patrickhener/dARts/docs/Hardware.rst

Hardware
========

Nachfolgend wird die Hardware aufgeführt, die zum Bau des Automaten notewendig ist.

Gekauft habe ich
----------------

Die nachfolgenden Teile sind eine Empfehlung und entsprechen den Teilen, die ich gekauft habe:

* Ardunio Mega 2560 (China Nachbau): |Arduino|
* Raspberry PI 3B+: |Pi|
* Knopf: |Knopf|
* Piezo Sensoren: |Piezo|
* Ultraschall Sensor: |US|
* Löwen Komplett Set inklusive Matrix: |LKS|
* Schloss: |Schloss|

Sonstiges hatte ich noch
------------------------

Was man sonst noch so braucht, habe ich noch rumliegen gehabt:

* Lötkolben
* Litze
* Prototyping Steckplatinen
* Lochraster Lötplatinen
* Widerstandsset
* Schrumpfschlauch
* Jumper Kabel
* LED Band 12V

.. |Arduino| raw:: html

    <a href="https://www.amazon.de/gp/product/B071D4KP6B/ref=ppx_yo_dt_b_search_asin_title?ie=UTF8&psc=1" target="_blank">Amazon</a>

.. |Pi| raw:: html

    <a href="https://www.amazon.de/Raspberry-1373331-Pi-Modell-Mainboard/dp/B07BDR5PDW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" target="_blank">Amazon</a>

.. |Knopf| raw:: html

    <a href="https://www.amazon.de/gp/product/B071VYM413/ref=ppx_yo_dt_b_asin_title_o02_s00?ie=UTF8&psc=1" target="_blank">Amazon</a>

.. |Piezo| raw:: html

    <a href="https://www.amazon.de/gp/product/B07KT4HC4G/ref=ppx_yo_dt_b_asin_title_o03_s00?ie=UTF8&psc=1" target="_blank">Amazon</a>

.. |US| raw:: html

    <a href="https://www.amazon.de/gp/product/B00LSJWRXU/ref=ppx_yo_dt_b_asin_title_o03_s00?ie=UTF8&psc=1" target="_blank">Amazon</a>

.. |LKS| raw:: html

    <a href="https://dartdoktor.de/lowen-darts/178--loewen-dart-komplett-set-nr3-matrix.html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" target="_blank">DartDoktor.de</a>

.. |Schloss| raw:: html

    <a href="https://dartdoktor.de/schloss/311-schloss-target-dart-tuer.html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" target="_blank">DartDoktor.de</a>
