patrickhener/dARts/docs/Holz.rst

Einkaufsliste Holz mit Vermaßung
================================

Ich habe einen Bauplan entworfen, der sich stark an |Video| orientiert. Die nachfolgenden Maße an Holz haben für mich gut funktioniert:

MDF
---

* Segmentbrett: 480mm x 520mm x 12mm

Sperrholz/Multiplex
-------------------

* Matrixbrett: 520mm x 520mm x 18mm
* Türe: 600mm x 750mm x 12mm
* Rückwand: 600mm x 750mm x 12mm
* 3x Stirnbretter: 750mm x 200mm x 12mm
* Boden: 750mm x 200mm x 12mm

.. |Video| raw:: html

    <a href="https://www.youtube.com/watch?v=mV_-dOnWDoY">Strappis Youtube Video</a>
