patrickhener/dARts/docs/index.rst

.. dARts documentation master file, created by
   sphinx-quickstart on Tue Jun 18 13:06:39 2019.
   You can adapt this file completely to your liking, but it should at least
   contain the root `toctree` directive.

Willkommen bei dARts!
=====================

Dies ist die Doku für das Projekt dARts. Eine Arduino und Raspberry Pi gesteuerte elektronische Dartscheibe in Automatenqualität.
Gestützt vom Scoreboard System |Dart-O-Mat 3000|

.. |Dart-O-Mat 3000| raw:: html

  <a href="https://github.com/patrickhener/dart-o-mat-3000/" target="_blank">Dart-O-Mat 3000</a>

.. toctree::
   :maxdepth: 1

   Motivation.rst
   Hardware.rst
   Holz.rst
   Kosten.rst
   Pinbelegung.rst
   Bauanleitung.rst
   Arduino.rst
   Python.rst
   System.rst
