patrickhener/dARts/docs/Kosten.rst

Hochrechnung aller Kosten
=========================

* Arduino: 16,00 €
* Header Platine: 17,50 €
* Raspberry Pi: 32,00 €
* SD Karte: 7,00 €
* Knopf: 8,00 €
* Piezos: 10,00 €
* Ultraschall Sensor: 4,00 €
* Löwen Komplett Set inklusive Matrix: 190,00 €
* Schloss: 10,00 €
* MDF: 2,50 €
* Sperrholz/Multiplex: 45,00 €
* Farbe: 9,00 €
* Walzen: 4,50 €
* Klebezahlen: 20,00 €

Nicht berücksichtigt wurden
---------------------------

* LED Band: 15,50 € (|LED|)
* Netzteil (Kombination aus Steckernetzteil und Adapter): 20,00 € (|Netzteil1| und |Netzteil2|)
* Kleinteile, wie zum Beispiel Litze, Widerstände, Schrumpfschlauch, ...: 25,00 €

.. |LED| raw:: html

  <a href="https://www.led-konzept.de/LED-Streifen-12V-weiss-24W-pro-5m-neutralweiss-200cm-ohne-Anschluesse" target="_blank">led-konzept.de</a>

.. |Netzteil1| raw:: html

  <a href="https://www.amazon.de/Goobay-Spannung-Adapterkabel-4-polig-3-polig/dp/B003KR3UMK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" target="_blank">Amazon</a>

.. |Netzteil2| raw:: html

  <a href="https://www.amazon.de/NAVILOCK-Netzteil-ext-240V-4-Pin/dp/B002V9S46K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" target="_blank">Amazon</a>

Summe
-----

Die Summe beläuft sich demnach auf: 436,00 €
