patrickhener/dARts/docs/Pinbelegung.rst

.. _Pinbelegung:
.. Tabelle generiert mit http://www.tablesgenerator.com/text_tables#

Pinbelegung
===========

+----------------------------+----------+-------------+
| Komponente                 | PIN      | PIN Arduino |
+----------------------------+----------+-------------+
| Push Button                | LED +    | 3           |
+                            +----------+-------------+
|                            | LED -    | GND         |
+                            +----------+-------------+
|                            | Signal + | 2           |
+                            +----------+-------------+
|                            | Signal - | GND         |
+----------------------------+----------+-------------+
| Ultraschall                | VCC      | 5V          |
+ Sensor                     +----------+-------------+
|                            | TRIG     | 9           |
+                            +----------+-------------+
|                            | ECHO     | 8           |
+                            +----------+-------------+
|                            | GND      | GND         |
+----------------------------+----------+-------------+
| Piezo1                     | S        | A0          |
+                            +----------+-------------+
|                            | \-       | GND         |
+----------------------------+----------+-------------+
| Piezo2                     | S        | A1          |
+                            +----------+-------------+
|                            | \-       | GND         |
+----------------------------+----------+-------------+
| Matrix Stecker             | 1        | 22          |
+                            +----------+-------------+
|                            | 2        | 24          |
+                            +----------+-------------+
|                            | 3        | 26          |
+                            +----------+-------------+
|                            | 4        | 28          |
+                            +----------+-------------+
|                            | 5        | 30          |
+                            +----------+-------------+
|                            | 6        | 32          |
+                            +----------+-------------+
|                            | 7        | 34          |
+                            +----------+-------------+
|                            | 8        | 36          |
+                            +----------+-------------+
|                            | 9        | 38          |
+                            +----------+-------------+
|                            | 10       | 40          |
+                            +----------+-------------+
|                            | 11       | 42          |
+                            +----------+-------------+
|                            | 12       | 44          |
+                            +----------+-------------+
|                            | 13       | 46          |
+                            +----------+-------------+
|                            | 14       | 48          |
+                            +----------+-------------+
|                            | 15       | 50          |
+                            +----------+-------------+
|                            | 16       | 52          |
+                            +----------+-------------+
|                            | 17       | 53          |
+                            +----------+-------------+
|                            | 18       | 51          |
+                            +----------+-------------+
|                            | 19       | 49          |
+                            +----------+-------------+
|                            | 20       | 47          |
+----------------------------+----------+-------------+
