patrickhener/dARts/docs/Motivation.rst

Meine Projektmotivation
=======================

Dieses Projekt ist ein Folgeprojekt aus dem Scoreboardprojekt *Dart-O-Mat 3000*. Der DOM3000 soll ein Scoreboard sein für Verwertung von Wurfdaten, die eine Bilderkennung während eines Steeldart Spieles sendet. Da das Scoreboard via RESTful API arbeitet kann es leicht adaptiert werden.
Ich selbst spiele ebenso gerne E-Dart, wie auch Steeldart. Dennoch ist es meist frustrierend, wie schlecht verarbeitet und dafür verhältnismäßig teuer elektronische Dartscheiben sind, die man so im Internet oder im Fachhandel erhalten kann. Die Löwenautomaten dagegen jedoch sind von der Qualität spitze.
So war schnell die Idee geboren eine E-Dart Scheibe in Form eines "Automaten" zu bauen und hierfür aus dem Ersatzteilelager von Löwen echte Automatenkomponenten zu verwenden.
Dieses Projekt ist demnach mein Versuch für ein günstiges Geld eine elektronische Dartscheibe zu erstellen, die eine Automatenqualität aufweist. Und das beste ist, dass ich den Dart-O-Mat 3000 so noch ein zweites mal verwenden konnte.
