patrickhener/dARts/(commit log)

2019-05-29 Grundsetup steht, Knopf Piezo und Ultraschall funktionieren
2019-05-29 Matrix drin. Knopf blinkt mit debounce. Nächster Schritt Python Script zum Verarbeiten der Befehle
2019-05-29 Python Script so gut wie fertig. Bust Handling fehlt noch und Fehlwurf Sensoren gehen leider auch nicht sooo gut.
2019-06-05 Script behandelt nun die Button LED. Einige weitere Verbesserungen
2019-06-05 Erster Piezo funktioniert zuverlässig. Mindestens 2. noch dazu. Button handling verbessert
2019-06-05 Matrix wird schlanker ausgelesen
2019-06-05 Stuck Dart Erkennung implementiert und mehrere (2) Piezos unterstützt
    [dARts.ino, dARts.py]
2019-06-05 Stuck Dart lässt button blinken
    [dARts.ino, dARts.py]
2019-06-06 andere Pins für besseres PCB Design
2019-06-06 Platinen Datei (GERBER) hinzugefügt)
2019-06-21 Ultraschallsensor repariert. Knopf blinkt wen US erkannt wird.
2019-07-05 Anpassung Makefile und gitignore für neuen Pi 4
